OpenSourceSDRLab/FMC-ADRV9009/images/FMC-ADRV9009-angle-2.jpg

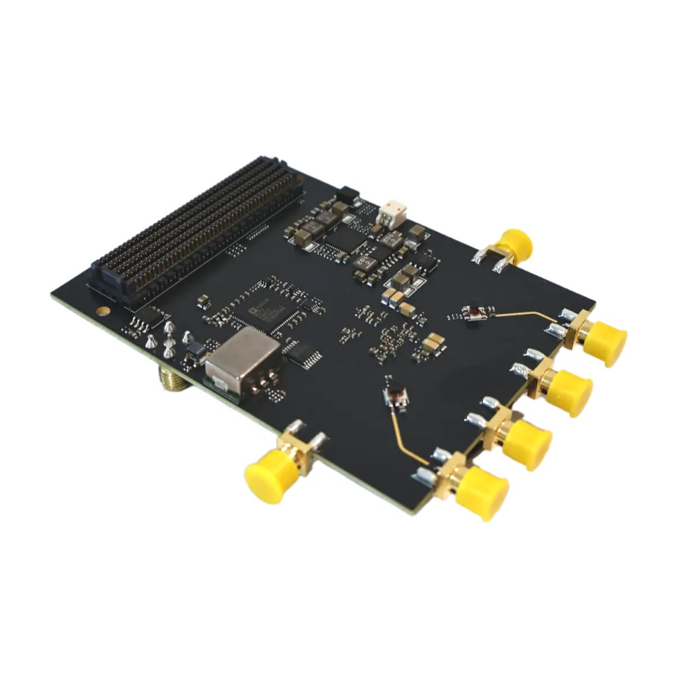
images/FMC-ADRV9009-angle-2.jpg
