OpenSourceSDRLab/FMC-ADRV9009/images/FMC-ADRV9009-angle-3.jpg

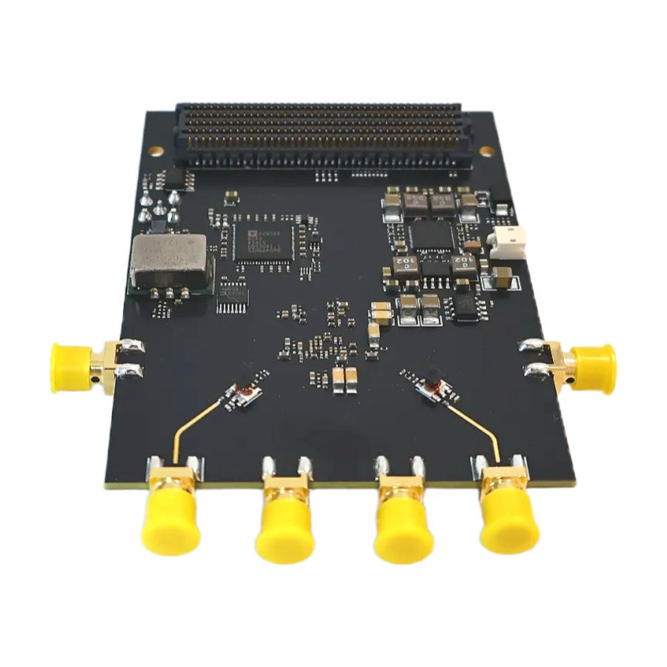
images/FMC-ADRV9009-angle-3.jpg
