OpenSourceSDRLab/FMC-ADRV9009/images/FMC-ADRV9009-bottom.jpg

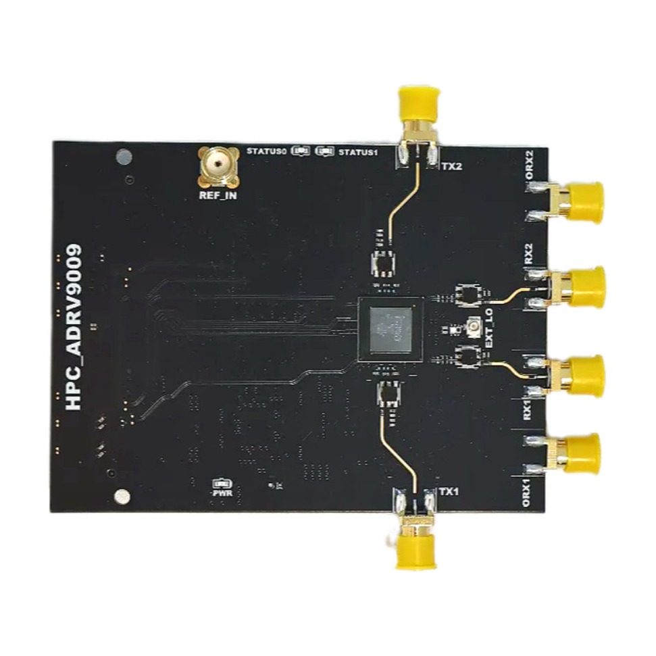
images/FMC-ADRV9009-bottom.jpg
