OpenSourceSDRLab/FMC-ADRV9009/images/FMC-ADRV9009-top-bottom.jpg

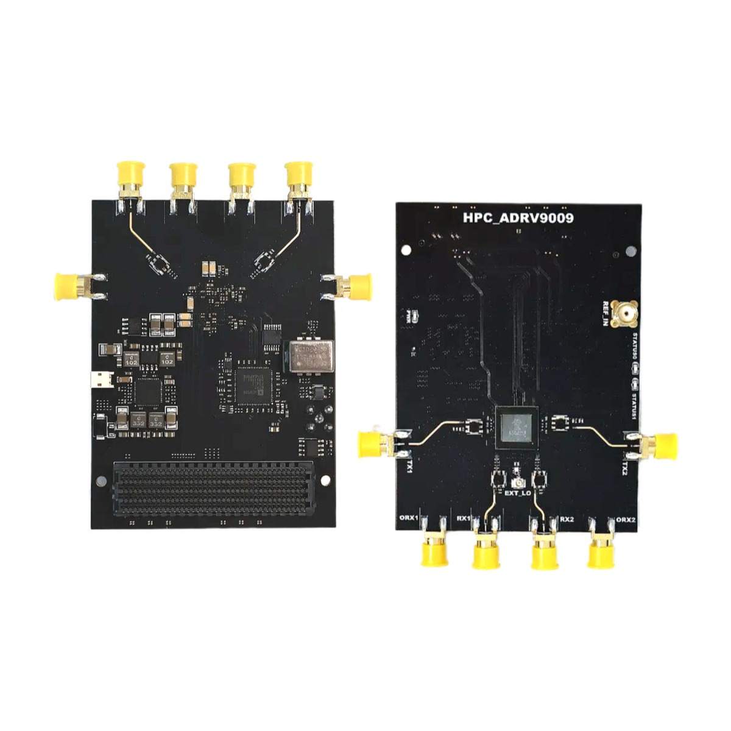
images/FMC-ADRV9009-top-bottom.jpg
