OpenSourceSDRLab/FMC-ADRV9009/images/FMC-ADRV9009-top.jpg

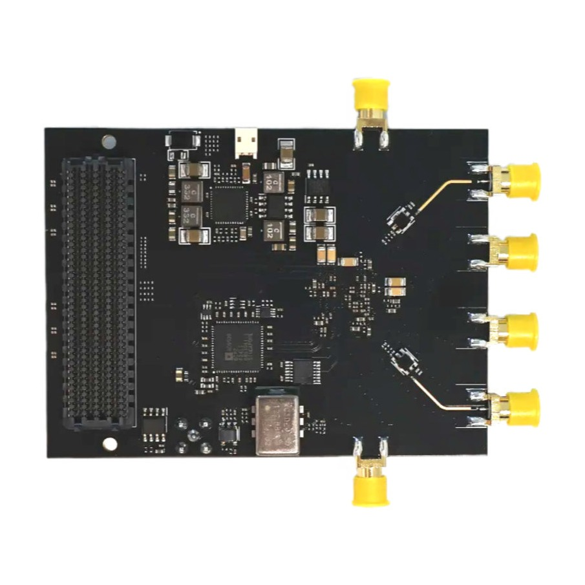
images/FMC-ADRV9009-top.jpg
