OpenSourceSDRLab/FMC-ADRV9009/hardware/FMC-ADRV9009_Schematic.pdf

# © 2026 OpenSourceSDRLab. All rights reserved. · www.opensourcesdrlab.com

# OPENSOURCESDRLAB DOCUMENTATION

# FMC-ADRV9009 Schematic

Product | FMC-ADRV9009
Document | OSSDRLAB-FMC-ADRV9009-SCH
Version | 1.0
Date | 2026-11-12

This document contains the circuit schematic of the OpenSourceSDRLab FMC-ADRV9009 board, exported from Altium Designer (A3). The seven schematic sheets follow this cover page.

Sheet | Content
1 | RF inputs: RX1, RX2, ORX1, ORX2 baluns
2 | RF outputs TX1 and TX2, external LO input/output
3 | Clocking: AD9528 clock generator, reference clock input, VCXO, status LEDs, SPI level conversion
4 | ADRV9009 GPIO interface and JESD204B SERDES lanes
5 | ADRV9009 power pins and decoupling
6 | Power supply: 12 V input, ADP5054 regulator, filtering, rail enables, clock supply
7 | FMC HPC connector

Product page: https://opensourcesdrlab.com/products/opensourcesdrlab-new-fmc-adrv9009-board-high-performance-board (https://opensourcesdrlab.com/products/opensourcesdrlab-new-fmc-adrv9009-board-high-performance-board)

# Questions about the hardware: support@opensourcesdrlab.com

# JP2R

# RX1 INPUT

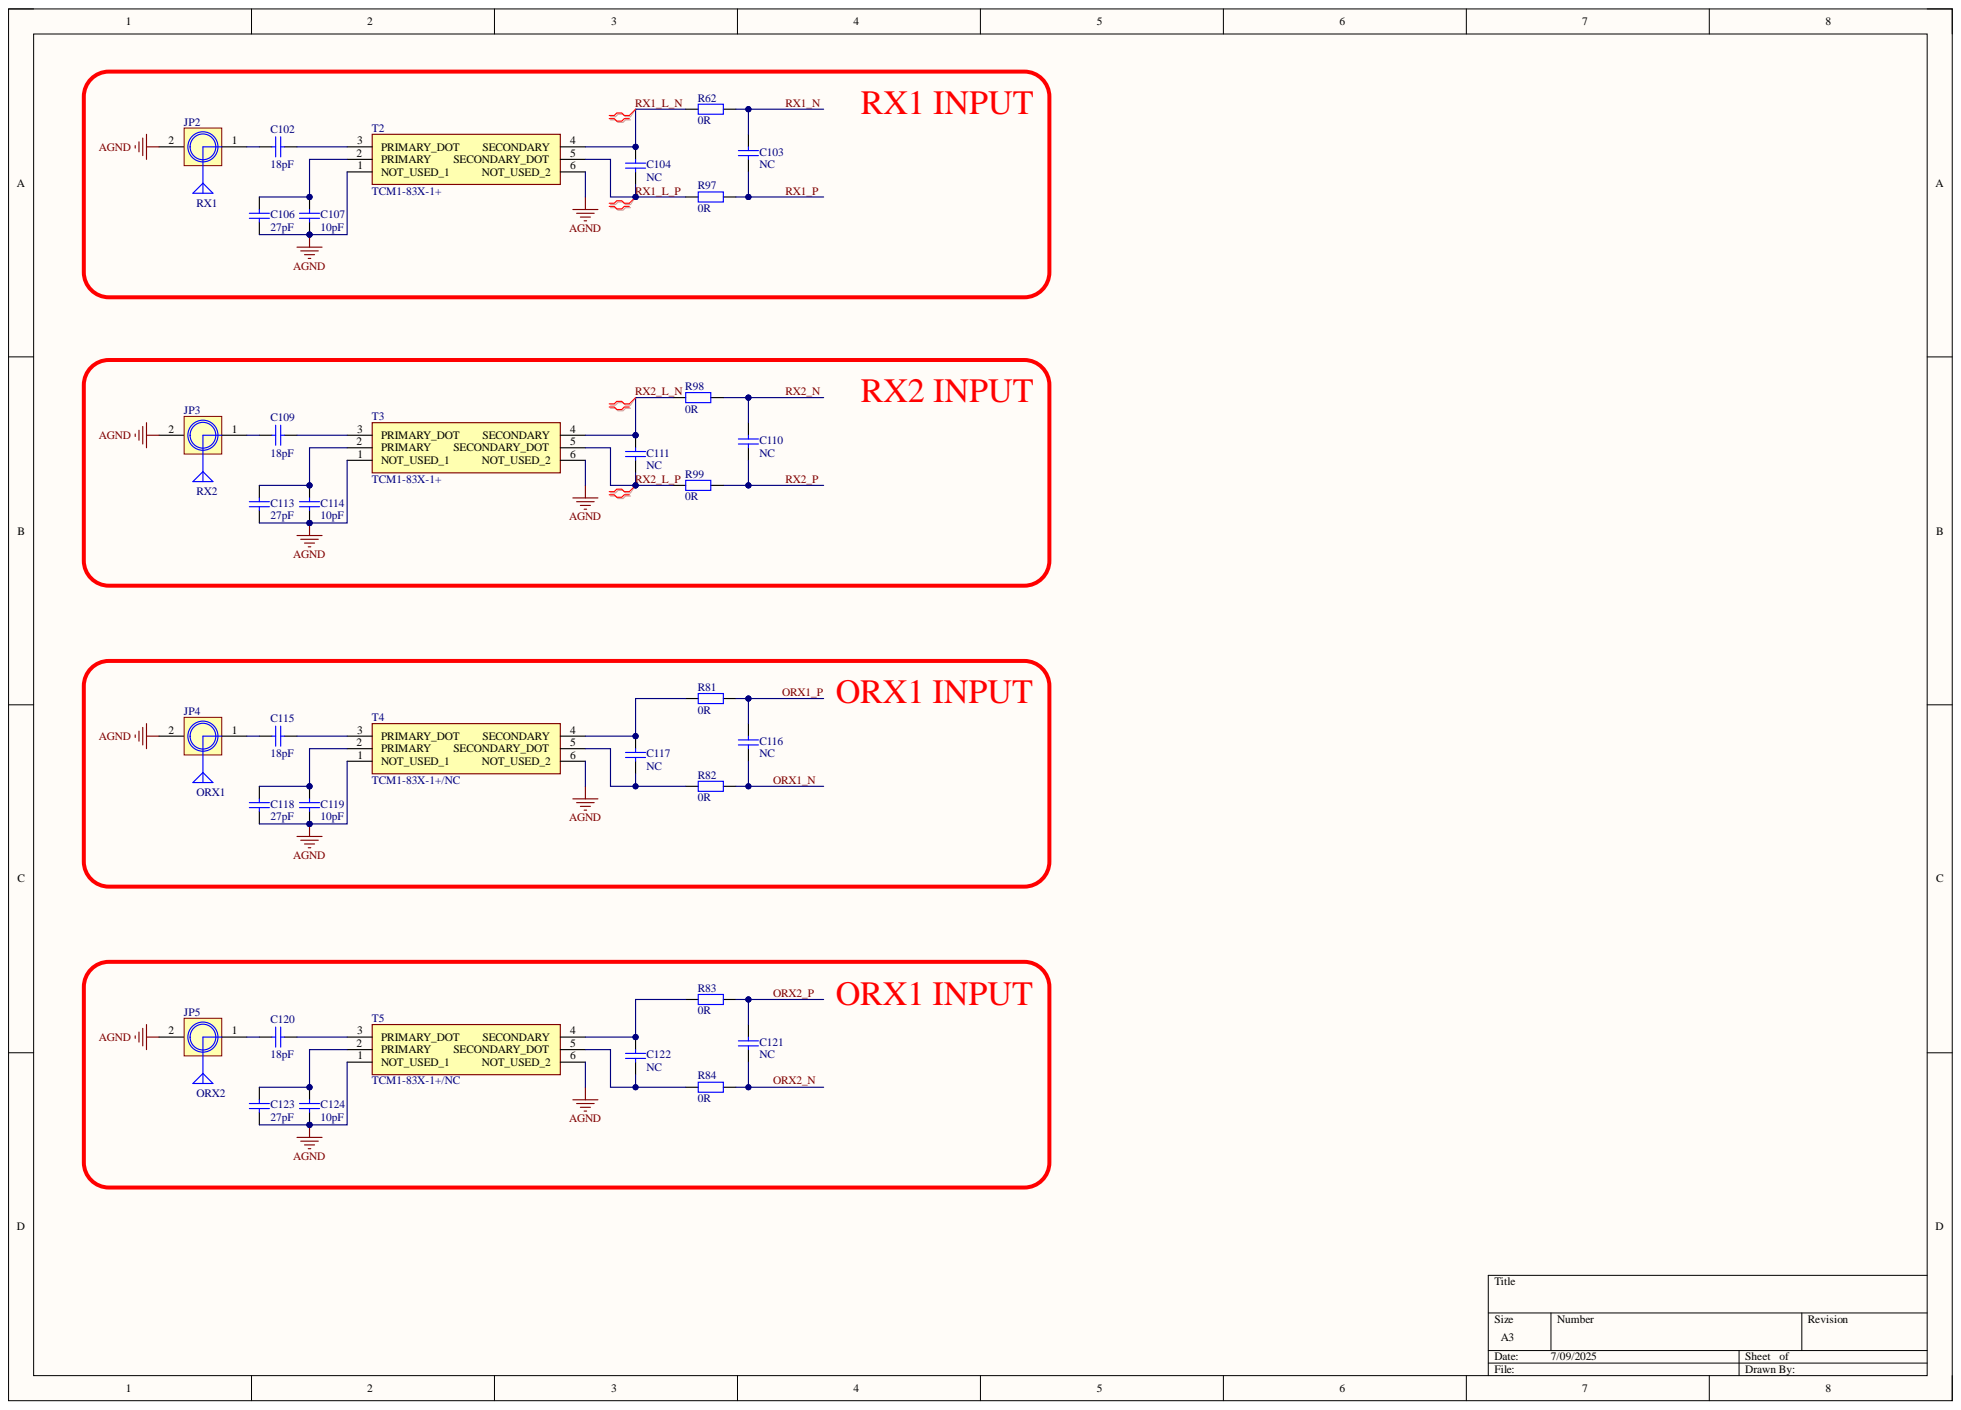
[picture p13: page 2]

11

22

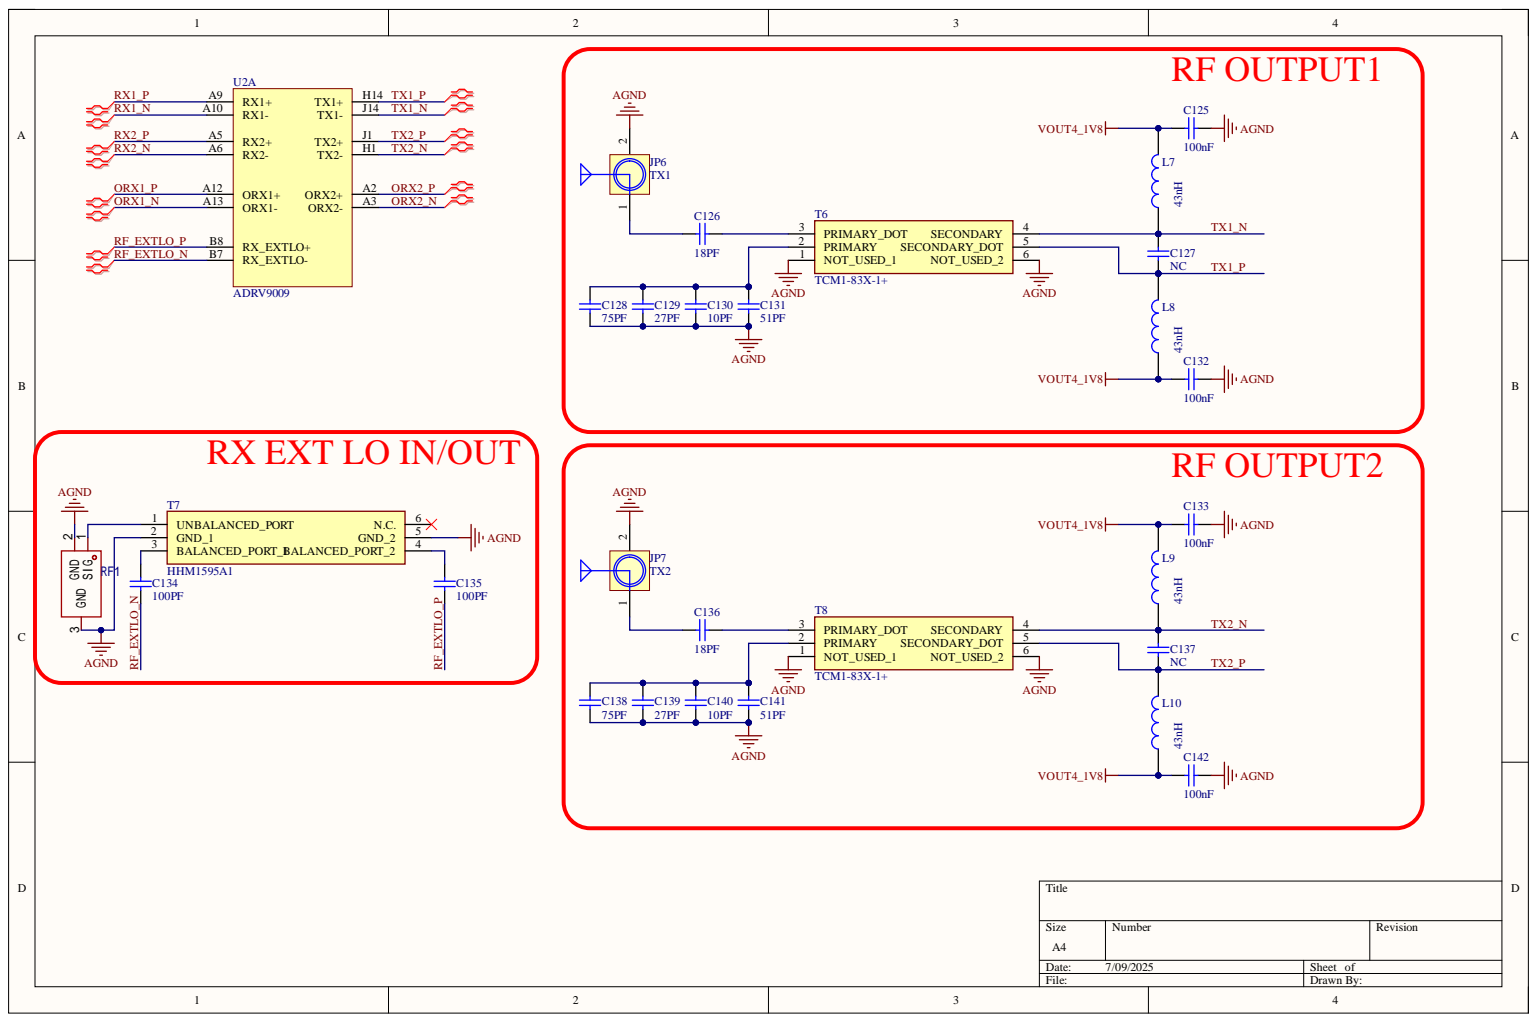
[picture p14: page 3]
Size; umb; Rev; Dat; Sheet; PRIMA; SECO; TCM1-8; NBA; NCE; EXTLO; RF OUTPUT1; RX_EXTLO+ B8; ORX

RF OUTPUT2 RX EXT LO IN/OUT
7HHM1

# REF CLK

# VCXO

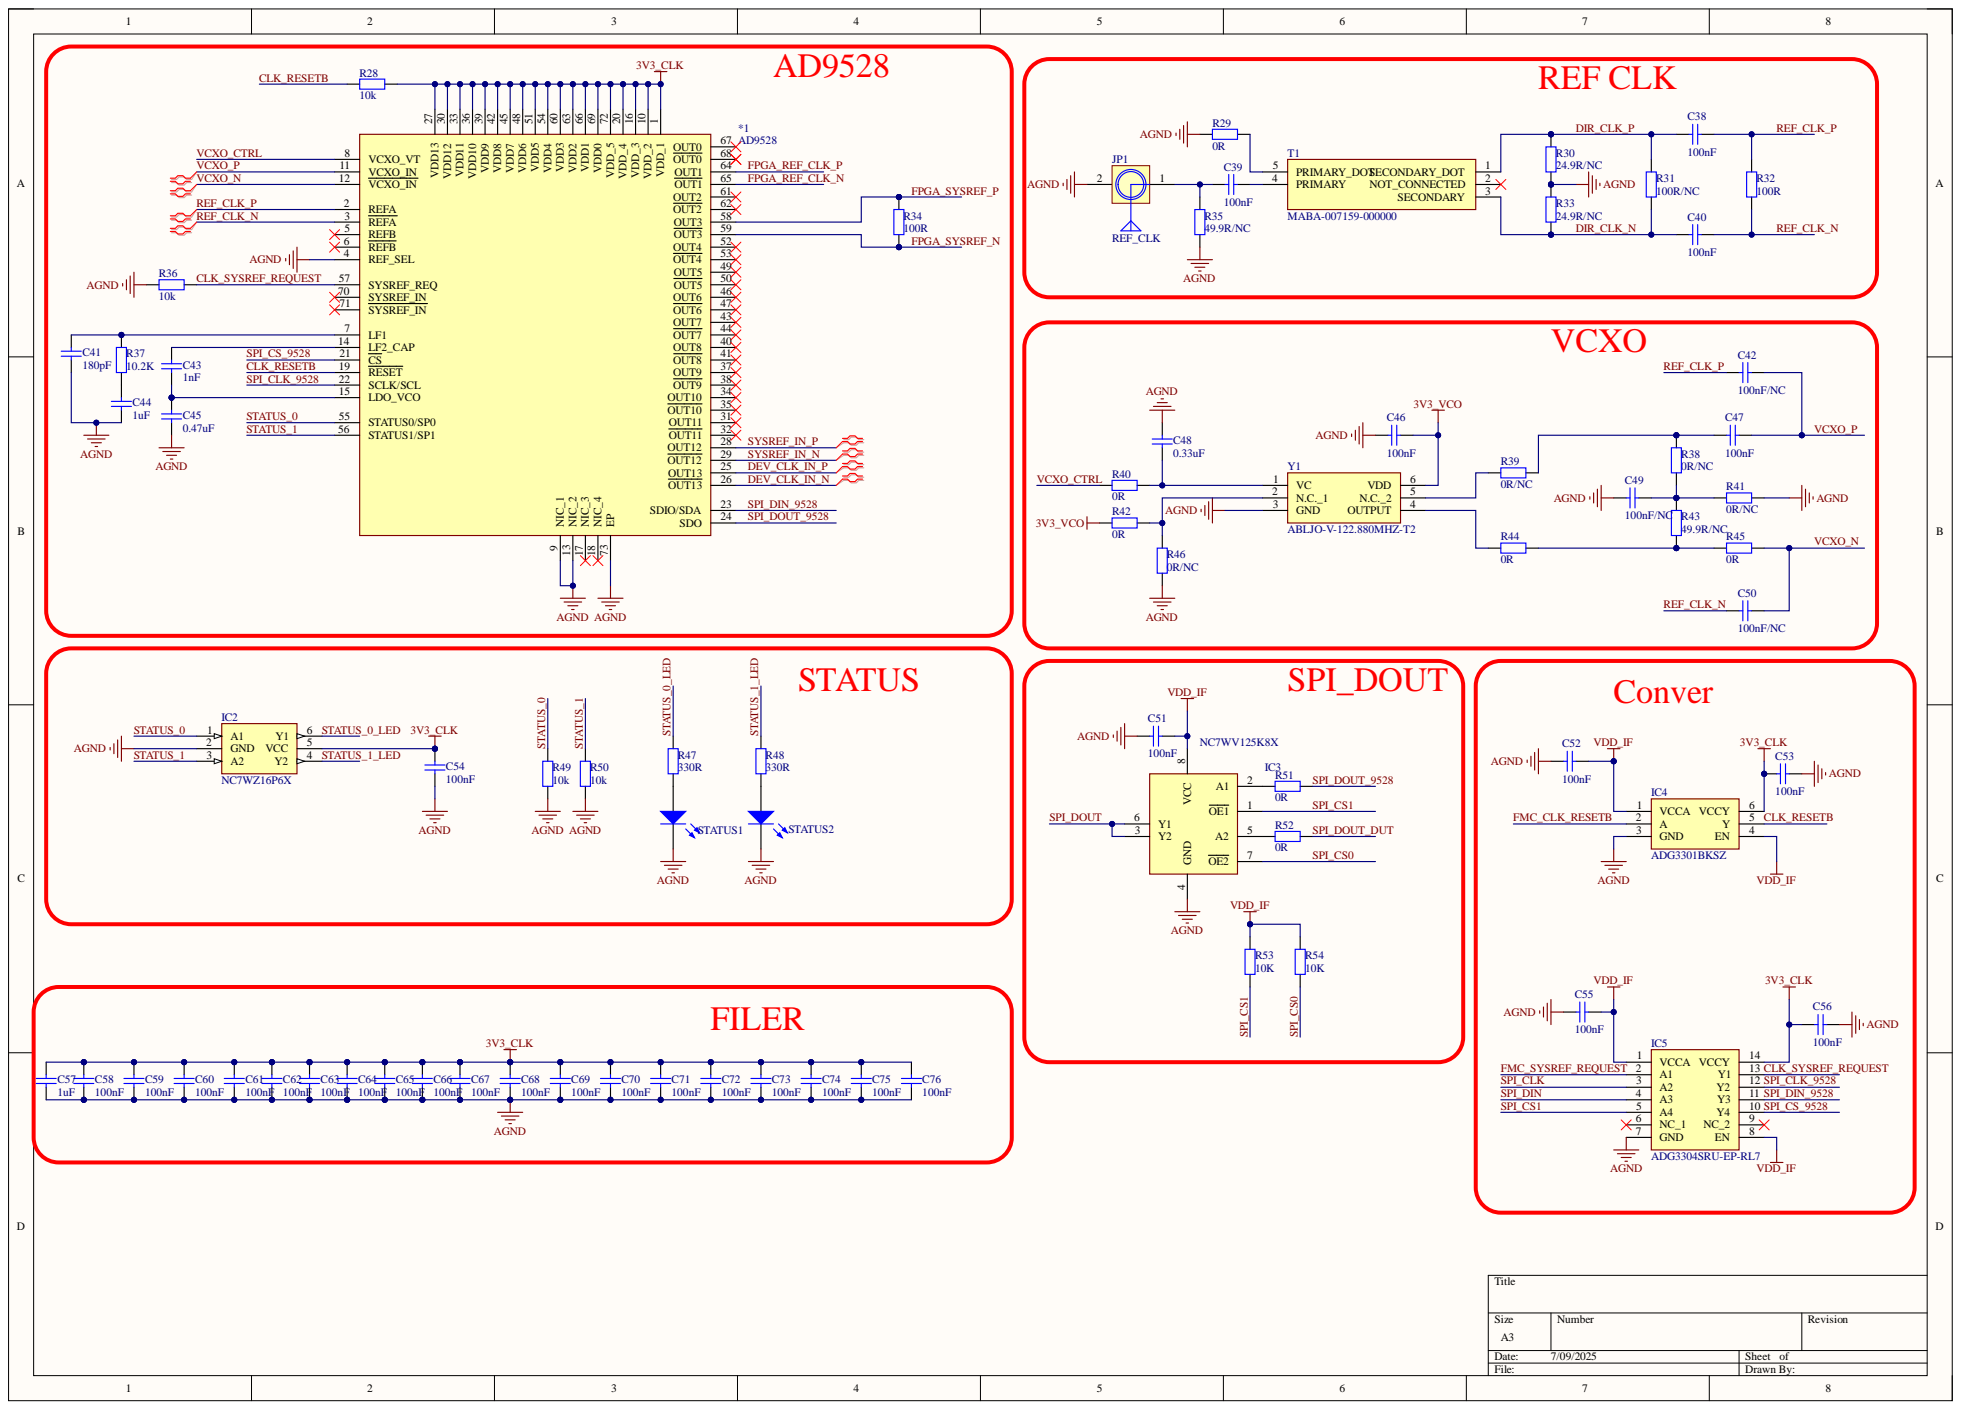
[picture p15: page 4]

A | A

0.1uF

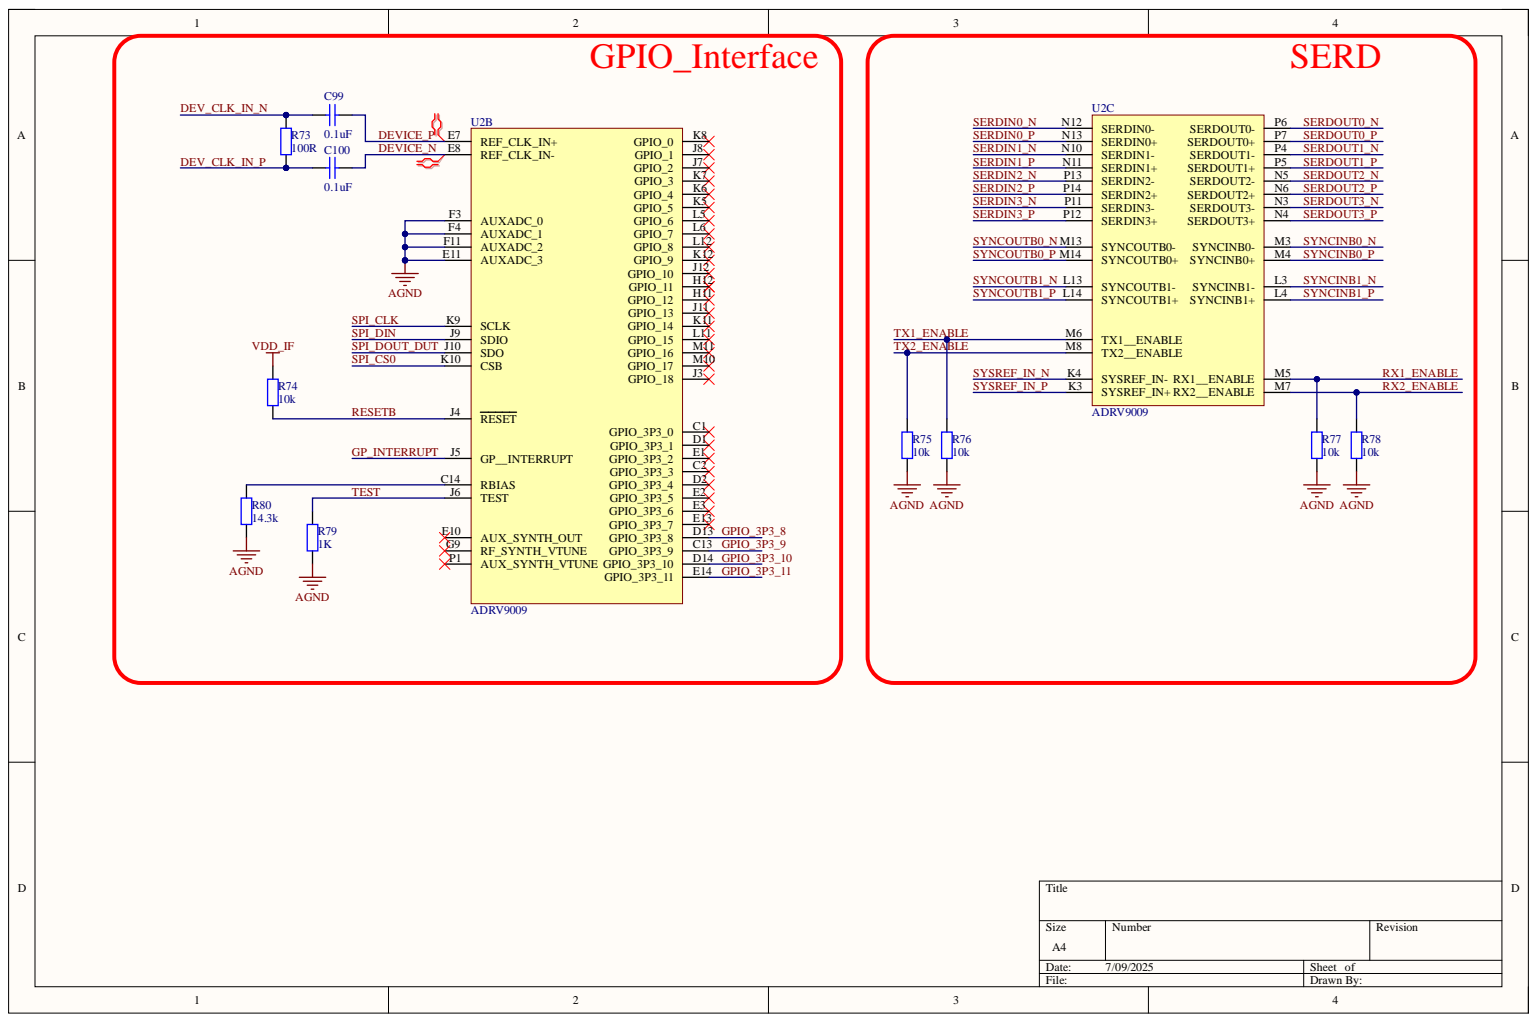
[picture p16: page 5]

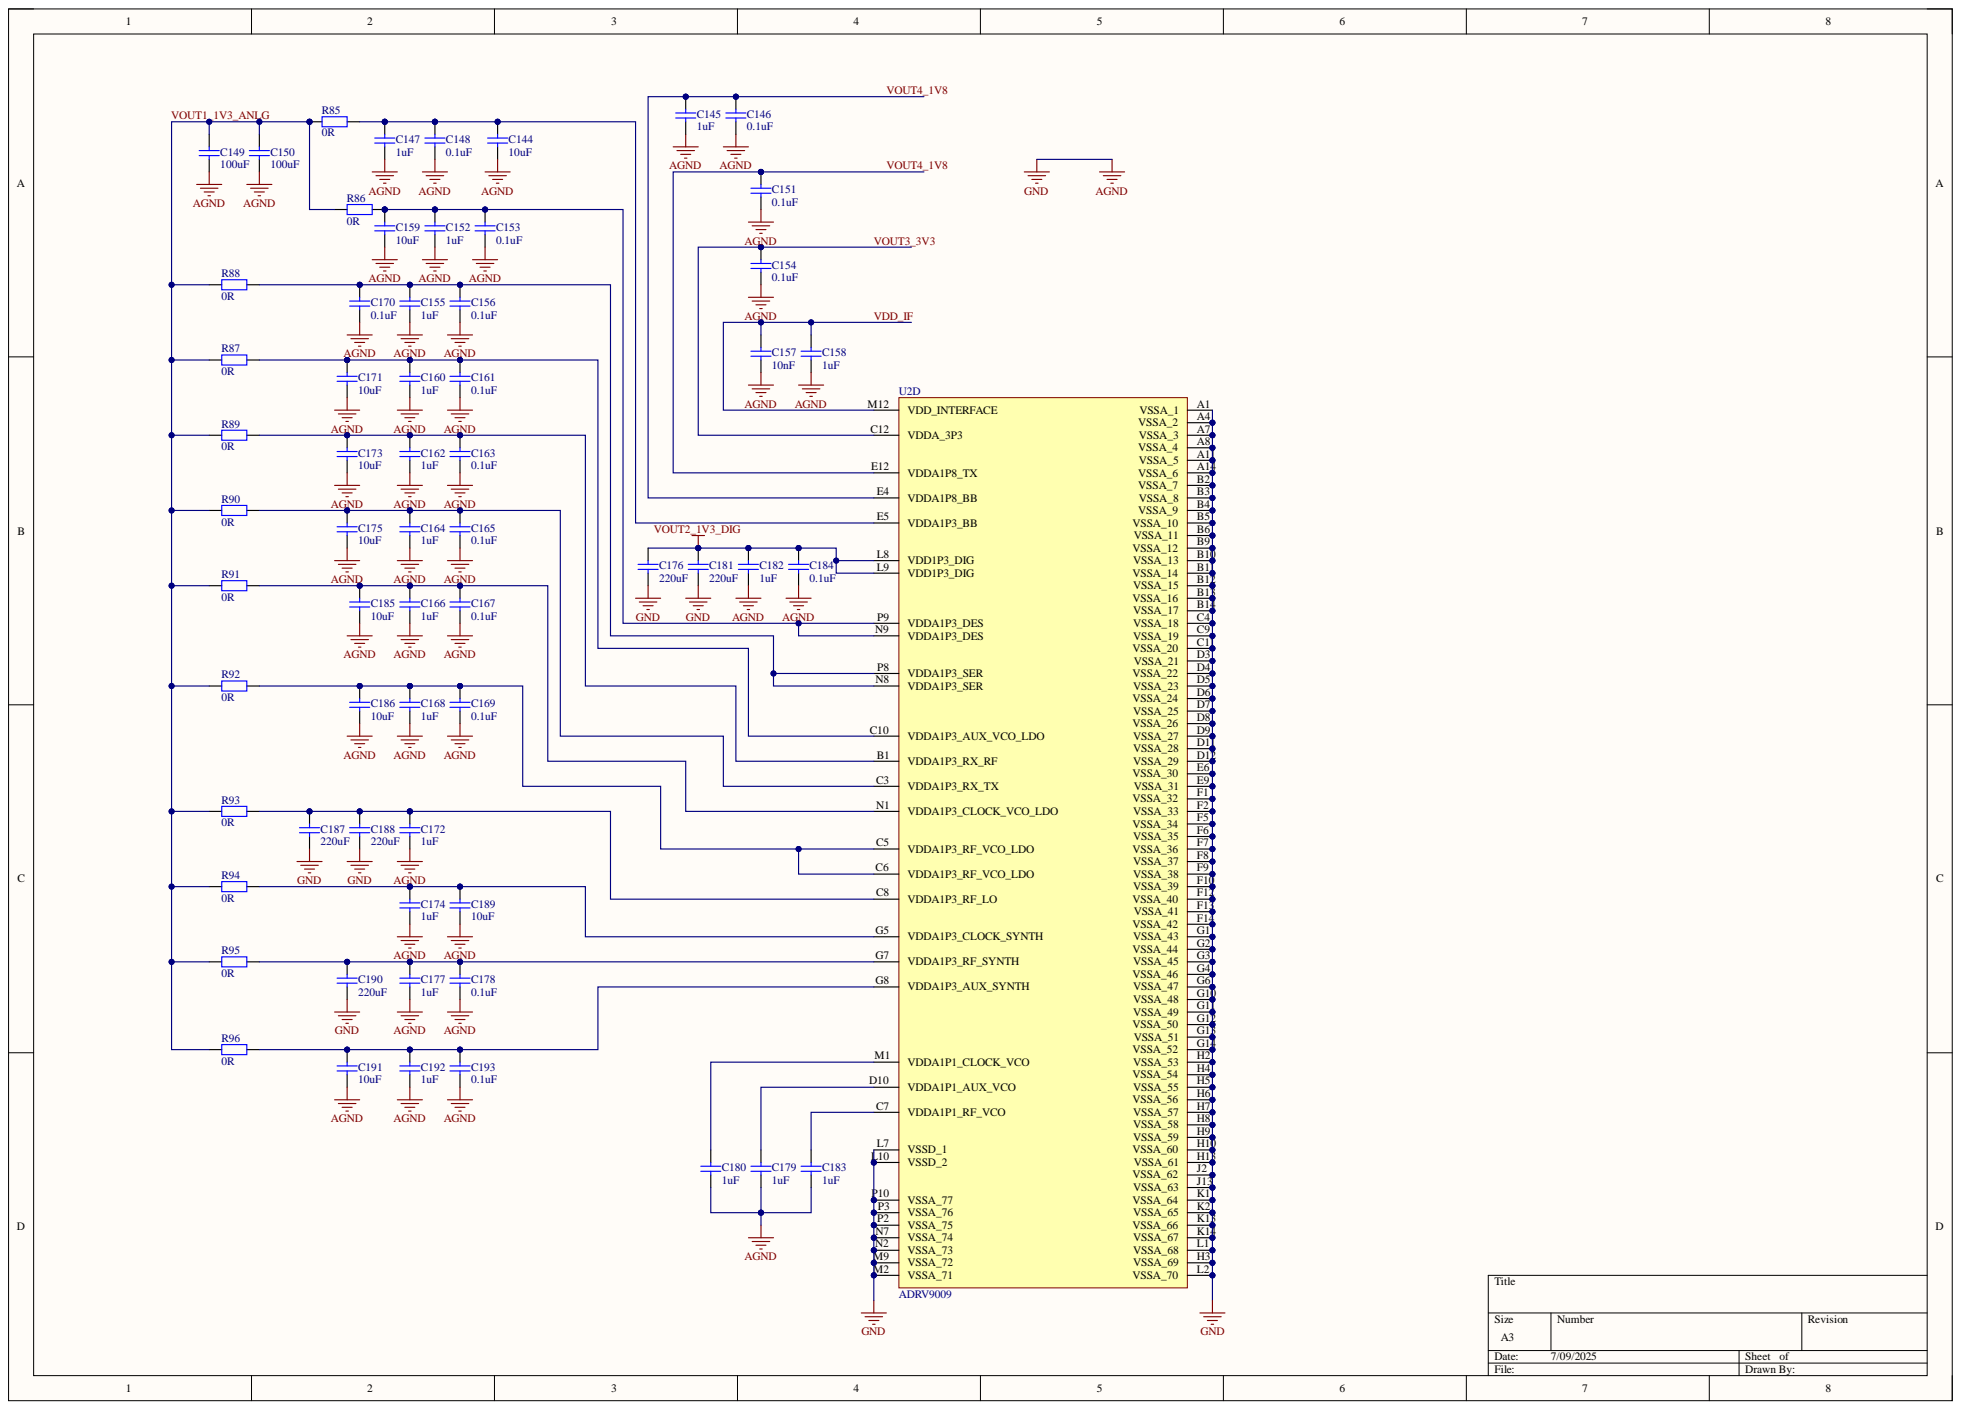
[picture p17: page 6]

# ADP5054

FeedBack | FILTER

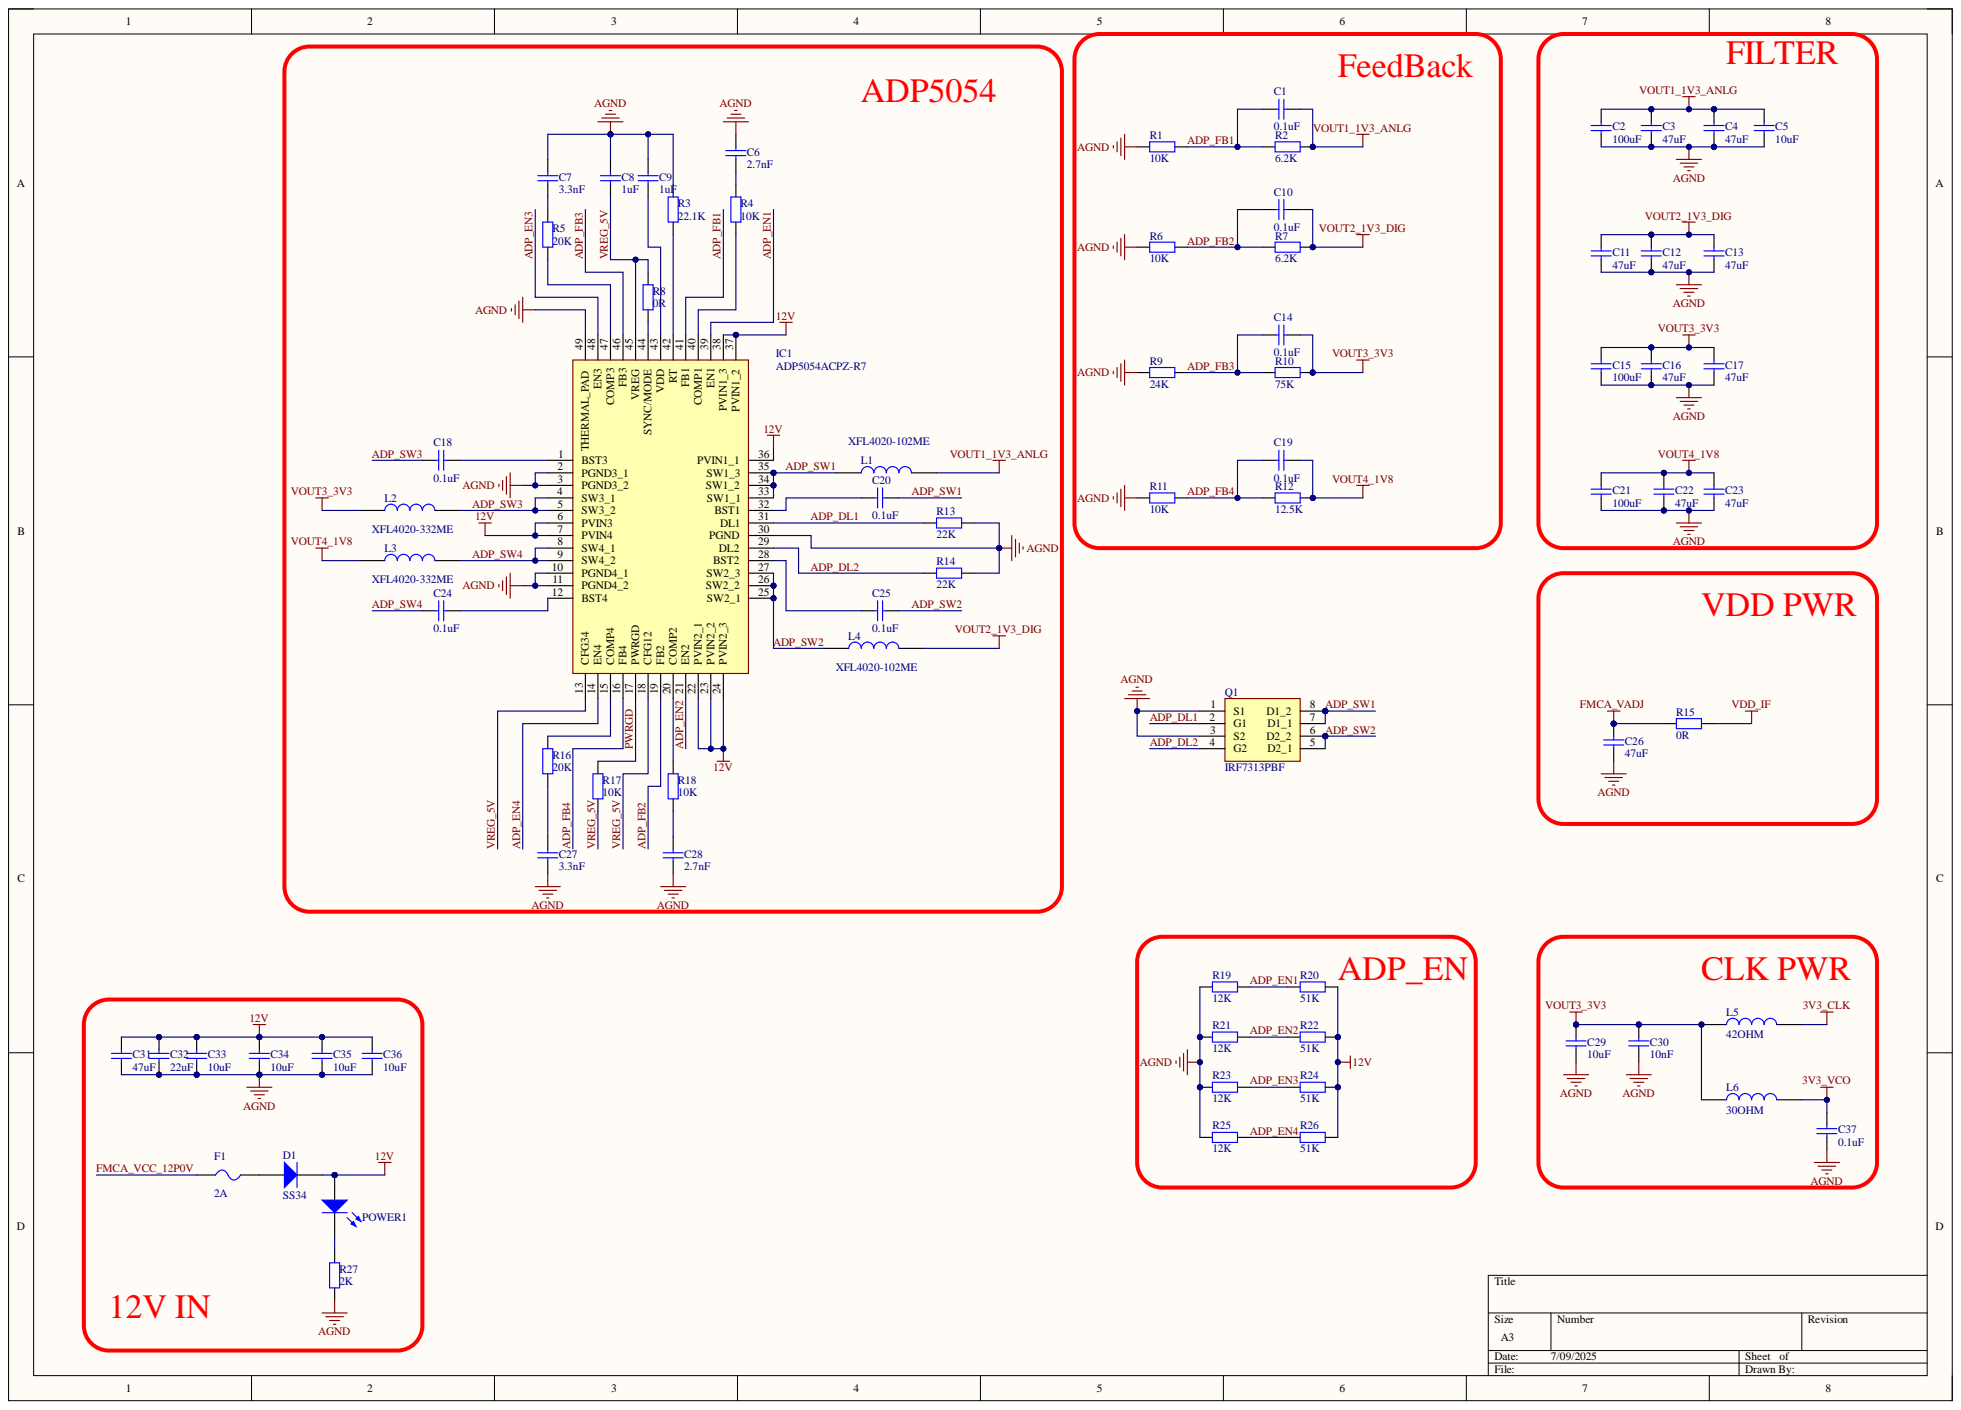
[picture p18: page 7]

F40 | F40 E40 E40 | E39 E39 | E38 E38 | E37 E37 | E36 E36 | E35 E35 | E34 E34 | E33 E33 | E32 E32 | E31 E31 | E30 E30 | E29 E29 | E28 E28 | E27 E27 | E26 E26 | E25 E25 | E24 E24 | E23 E23 | E22 E22 | E21 E21 | E20 E20 | E19 E19 | E18 E18 | E17 E17 | E16 E16 | E15 E15 | E14 E14 | E13 E13 | E12 E12 | E11 E11 | E10 E10 | E9 E9 | E8 E8 | E7 E7 | E6 E6 | E5 E5 | E4 E4 | E3 E3 | E2 E2 | E1 E1
K40 | K40 J40 J40 | J39 J39 | J38 J38 | J37 J37 | J36 J36 | J35 J35 | J34 J34 | J33 J33 | J32 J32 | J31 J31 | J30 J30 | J29 J29 | J28 J28 | J27 J27 | J26 J26 | J25 J25 | J24 J24 | J23 J23 | J22 J22 | J21 J21 | J20 J20 | J19 J19 | J18 J18 | J17 J17 | J16 J16 | J15 J15 | J14 J14 | J13 J13 | J12 J12 | J11 J11 | J10 J10 | J9 J9 | J8 J8 | J7 J7 | J6 J6 | J5 J5 | J4 J4 | J3 J3 | J2 J2 | J1 J1

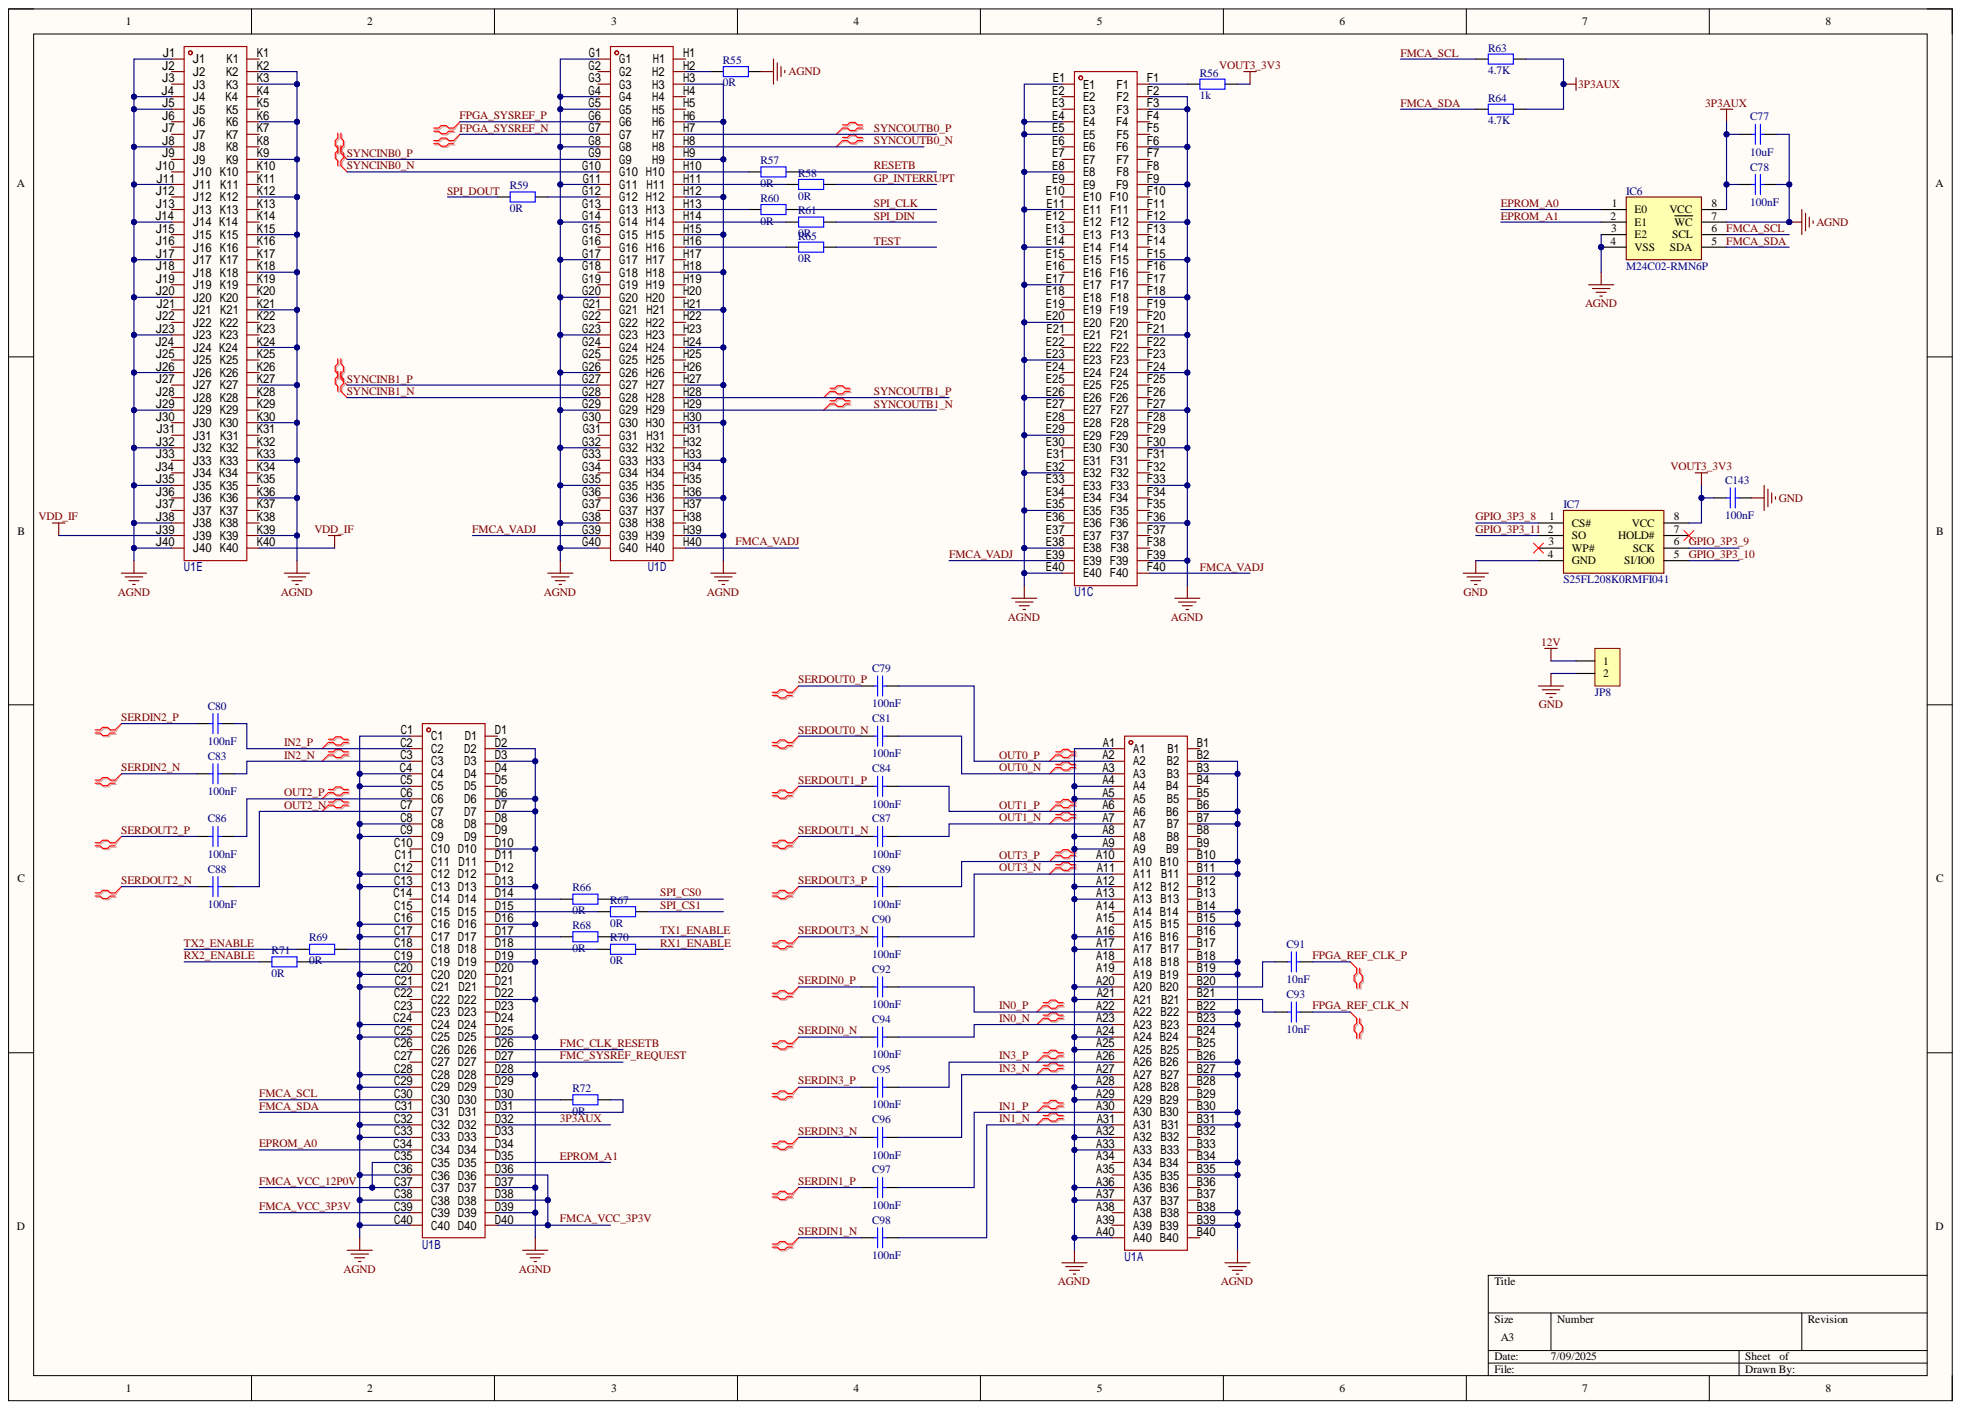
[picture p19: page 8]
