OpenSourceSDRLab/FMC-ADRV9009/vivado/7100/FMC_ADRV9009_PS/src/devices/adi_hal/change_rfpll.h

/*
 * change_rfpll.h
 *
 * Copyright (c) OpenSourceSDRLab
 * https://www.opensourcesdrlab.com
 */

#ifndef SRC_CHANGE_RFPLL_H_
#define SRC_CHANGE_RFPLL_H_
void change_rfpll(taliseDevice_t talDevice, uint64_t new_freq);

#endif /* SRC_CHANGE_RFPLL_H_ */
